tigertech119/Digital-System-Design--DSD-build-files/1. 1-bit-ALU/README.md

\# 1-Bit ALU Design Using Logic Gates and Multiplexer

compared to the prototype design
this is also a 1 bit alu design but more optimized. 
---needs less ICs
---needs less wires
---needs less power and GND support
---needs less spce (less breadboards)
