tigertech119/Digital-System-Design--DSD-build-files/2.if-stage/Docs/NE555/README.md

# NE555 Timer Clock Connection for IF Stage Hardware

## Overview

This project note explains how the **NE555 timer** was used in the hardware implementation of the **IF stage** to generate clock pulses for the D flip-flop based Program Counter and related synchronous parts.

In simulation, the clock setup behaved differently, but in real hardware the NE555 timer was used to generate a more practical repeating clock signal. This became important because manual clocking and timing mismatches caused unstable triggering behavior in flip-flops. :contentReference[oaicite:1]{index=1}

---

## Purpose

The NE555 timer was used to:

- generate a repeating clock pulse
- provide a more stable hardware clock than manual triggering
- help the D flip-flop based PC update step by step
- reduce multiple unwanted edge-trigger events caused by manual switching

This timer is part of the **hardware clock generation** only. It is separate from the Arduino-based EEPROM writing setup. The Arduino is used only for EEPROM programming and verification. :contentReference[oaicite:2]{index=2}

---

## Main Idea

The NE555 was connected in **astable mode** so that it continuously generates clock pulses.

Those pulses are used in the current IF stage hardware to drive the register/flip-flop timing.

In your hardware notes, the corrected practical connection was:

- pin 8 → VCC
- pin 4 → VCC
- pin 1 → GND
- pin 7 → R1 (10kΩ) → VCC
- pin 7 → R2 (100kΩ) → pins 2 and 6
- pin 2 shorted to pin 6
- pins 2/6 → capacitor 10µF → GND
- pin 5 → 0.01µF → GND
- pin 3 → output clock :contentReference[oaicite:3]{index=3}

---

## Components Used

- **NE555 Timer IC**
- **10kΩ resistor**
- **100kΩ resistor**
- **10µF capacitor**
- **0.01µF capacitor** (103)
- breadboard
- jumper wires
- power supply

Your resistor set also matches this arrangement:
- one group labeled **10kΩ**
- one group labeled **100kΩ** :contentReference[oaicite:4]{index=4}

---

## Corrected Pin Connections

## Full Pin List

| NE555 Pin | Connection |
|---|---|
| Pin 1 | GND |
| Pin 2 | Short to Pin 6 |
| Pin 3 | Clock output |
| Pin 4 | VCC |
| Pin 5 | 0.01µF capacitor to GND |
| Pin 6 | Short to Pin 2 |
| Pin 7 | To R1 and R2 junction path |
| Pin 8 | VCC |

### External Component Connections

| Part | Connection |
|---|---|
| R1 = 10kΩ | between VCC and Pin 7 |
| R2 = 100kΩ | between Pin 7 and Pins 2/6 |
| C = 10µF | between Pins 2/6 and GND |
| 0.01µF capacitor | between Pin 5 and GND |

This is the corrected hardware-side connection you used for the current IF stage clock source. :contentReference[oaicite:5]{index=5}

---

## Text Wiring Diagram

```text
VCC ---- R1 (10kΩ) ---- Pin 7
Pin 7 ---- R2 (100kΩ) ---- Pins 2 and 6
Pins 2 and 6 ---- 10µF capacitor ---- GND
Pin 5 ---- 0.01µF capacitor ---- GND
Pin 4 ---- VCC
Pin 8 ---- VCC
Pin 1 ---- GND
Pin 3 ---- Clock Output

---

How It Works

The NE555 charges and discharges the timing capacitor repeatedly through the resistor network.

the 10kΩ and 100kΩ resistors help set the charge/discharge timing
the 10µF capacitor determines how long one cycle lasts
the output pulse is taken from Pin 3
the 0.01µF capacitor on Pin 5 helps reduce noise and improve stability

This produces a continuous pulse train that can be used as a clock signal.

Why This Was Needed

During the IF stage hardware work, timing issues appeared:

manual clocking produced inconsistent triggering
the D flip-flop timing did not always match Proteus behavior
the hardware needed a more repeatable clock signal

Using the NE555 made the hardware clock more practical. It also helped reduce the negative-edge/manual-pulse related confusion that appeared while building the IF stage.

Practical Notes
The hardware connection used in the current IF stage is not exactly the same as the Proteus setup
In real breadboard hardware, small timing differences matter more
Keep jumper wires short to reduce noise
Check capacitor polarity carefully for the 10µF electrolytic capacitor
Keep Pin 4 tied HIGH to avoid accidental reset
Use the output from Pin 3 as the clock source
Problems Faced

Some practical issues appeared during use:

1. Clock pulse mismatch

The real hardware and Proteus did not behave exactly the same.

2. Manual pulse problem

Manual triggering created multiple unwanted edges and unstable operation.

3. Timing sensitivity

D flip-flops required proper pulse timing, so unstable clocks caused incorrect behavior.

4. Need for corrected resistor-capacitor values

The final clock setup became stable only after using the corrected resistor and capacitor arrangement.

---
