tigertech119/Digital-System-Design--DSD-build-files/1. 1-bit-ALU/images/1-bit-alu-final-design-samia-musamarked-ic-number.jpeg

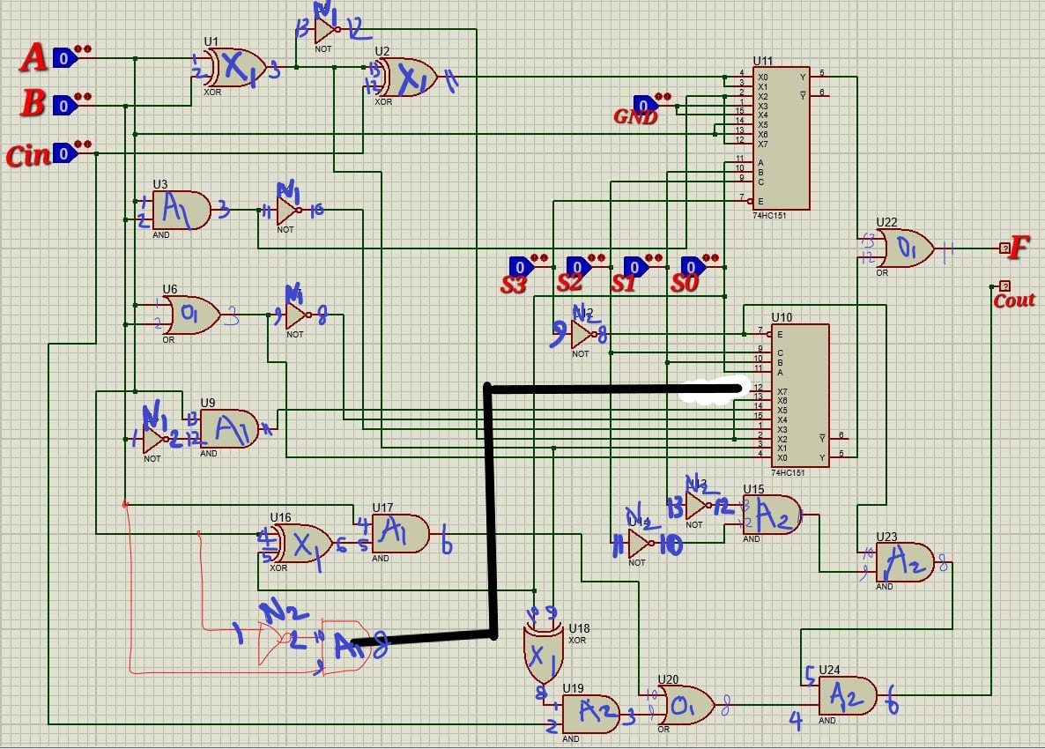
1. 1-bit-ALU/images/1-bit-alu-final-design-samia-musamarked-ic-number.jpeg
