tigertech119/Digital-System-Design--DSD-build-files/1. 1-bit-ALU/images/hardware.png

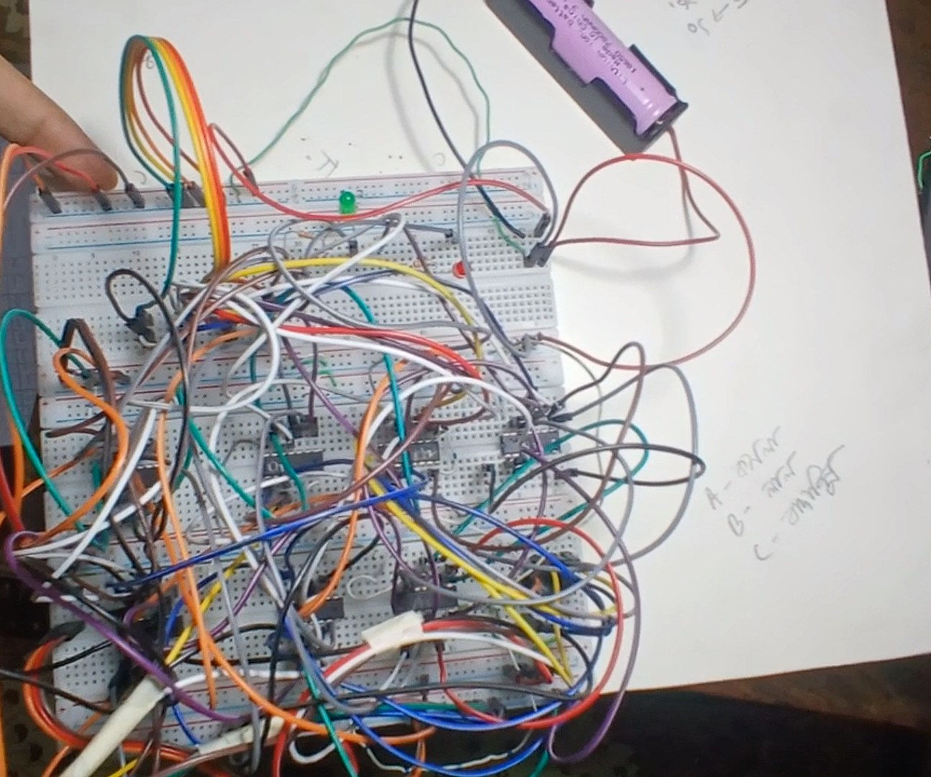
1. 1-bit-ALU/images/hardware.png
