tigertech119/Digital-System-Design--DSD-build-files/2.if-stage/Docs/NE555/ne555_marked.png

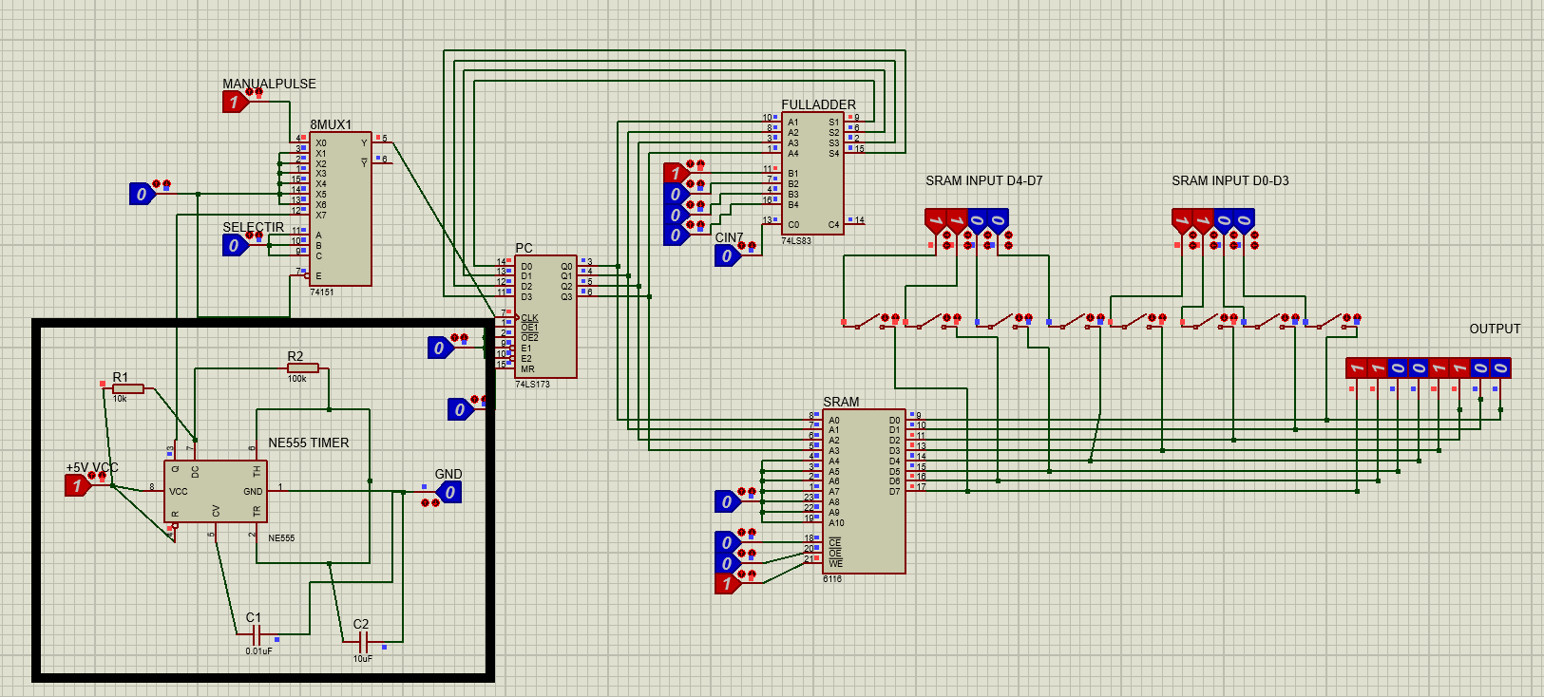
2.if-stage/Docs/NE555/ne555_marked.png
