tigertech119/Digital-System-Design--DSD-build-files/2.if-stage/images/if stage final design using 6116.png

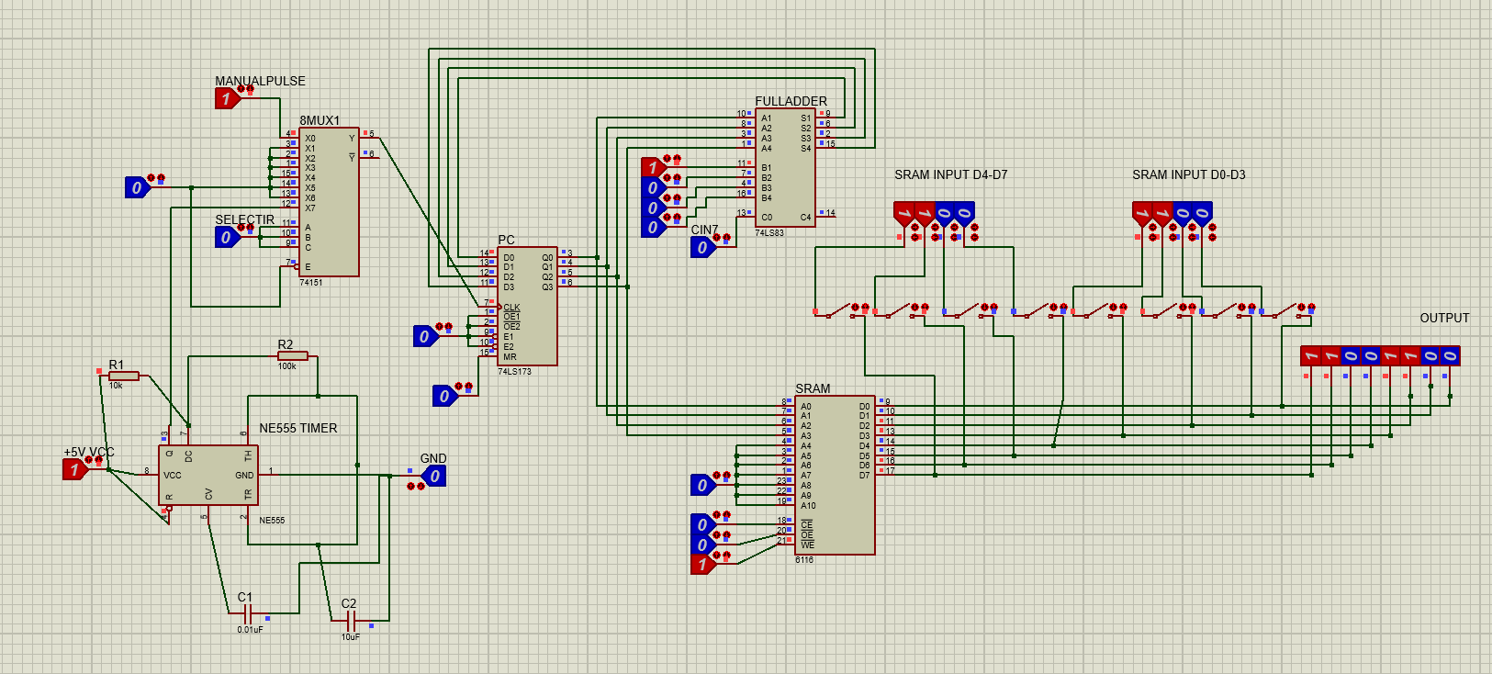
2.if-stage/images/if stage final design using 6116.png
