tigertech119/Digital-System-Design--DSD-build-files/2.if-stage/images/ifsatgetable.png

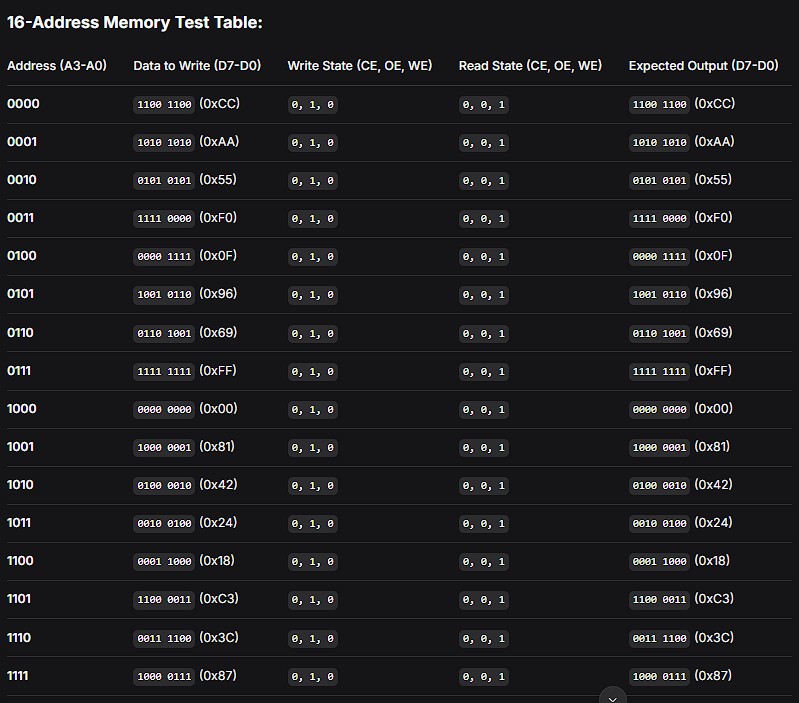
2.if-stage/images/ifsatgetable.png
