tigertech119/Digital-System-Design--DSD-build-files/(list of files, drawings)

Other design files:
1. 1-bit-ALU/proteus/1-bit-alu-final-design-samia.pdsprj
2.if-stage/proteus/IFstgMUSAfina6116butreally2816.pdsprj
