tigertech119/Digital-System-Design--DSD-build-files/2.if-stage/Docs/ARDUINO UNO CONNECTIONS FOR WRITING DATA/Arduino readwrite setup-front.jpg

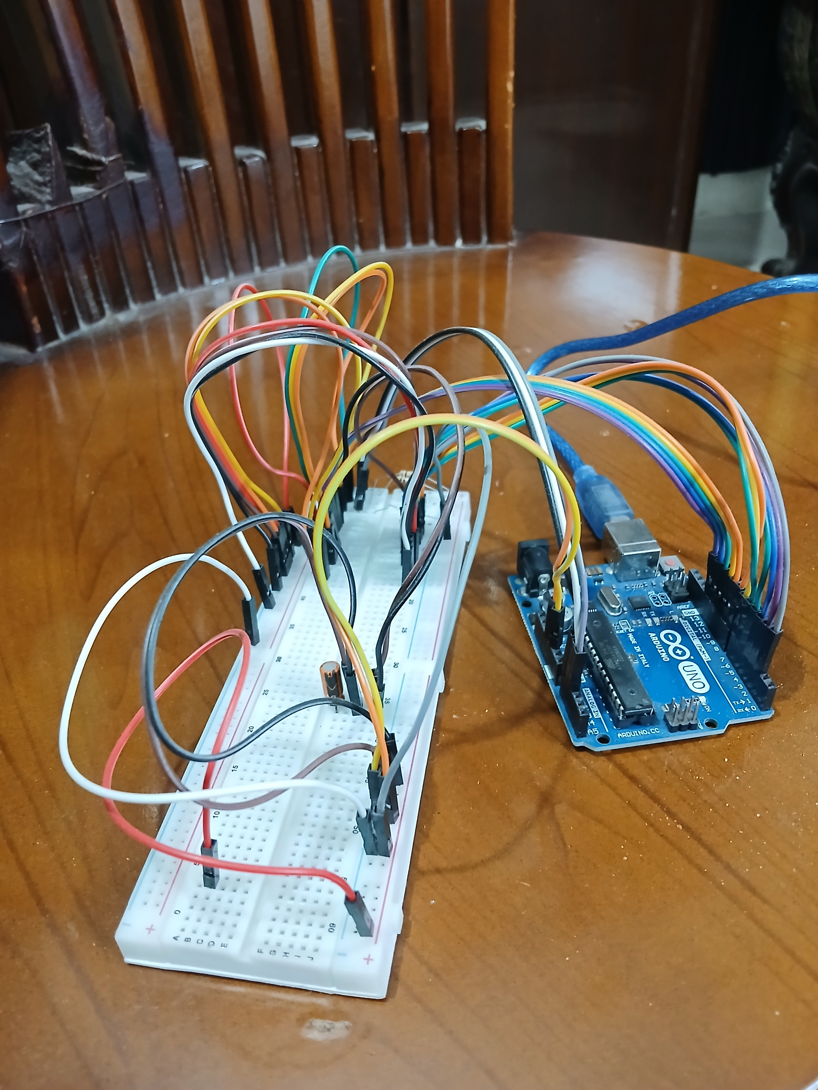
2.if-stage/Docs/ARDUINO UNO CONNECTIONS FOR WRITING DATA/Arduino readwrite setup-front.jpg
