tigertech119/Digital-System-Design--DSD-build-files/(commit log)

2026-04-24 alu added
    [1-bit-alu-final-design-samia.pdsprj]
2026-04-24 if stage added
    [IFstgMUSAfina6116butreally2816.pdsprj]
